Jelte-Boumans/soldeertin-dispenser/Posters/Illustratieve poster V4.pdf

# MANUEEL DRAAD KNIPPEN STOPT HIER STOP

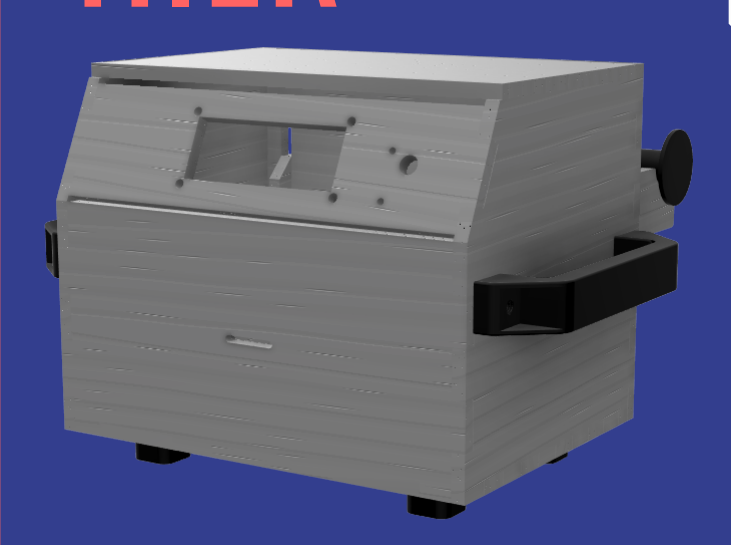
[picture p1: figure]

AUTOMATIC SOLDER DISPENSER COMING SOON TO AP HOGESCHOOL

Made by Jelte Boumans
