Jelte-Boumans/soldeertin-dispenser/Posters/Informatieve poster V1.pdf

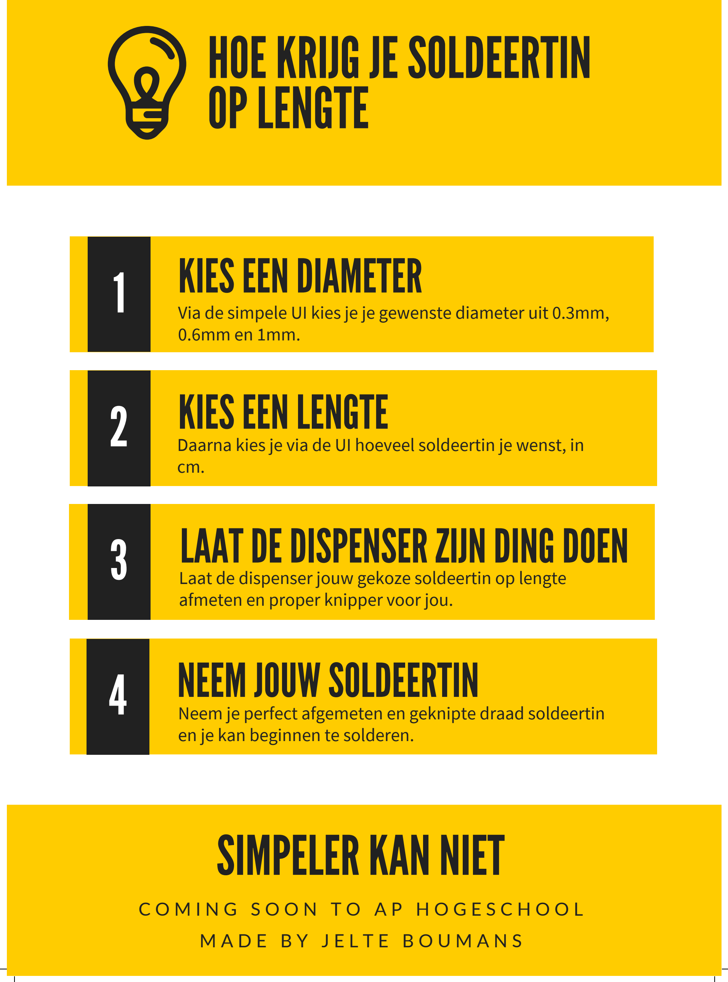
[picture p40: figure]
HOEKRIJGJESOLDEERTIN OPLENGTE; KIESEENDIAMETER; LAATDEDISPENSERZIJNDINGDOEN; afmeten en proper knipper voor jou.; NEEM JOUW SOLDEERTIN; en je kan beginnen te solderen.; SIMPELERKANNIET; KIESEENLENGTE

Via de simpele UI kies je je gewenste diameter uit 0.3mm,

Laat de dispenser jouw gekoze soldeertin op lengte

Neem je perfect afgemeten en geknipte draad soldeertin

C O M I N G S O O N T O A P H O G E S C H O O L

Daarna kies je via de UI hoeveel soldeertin je wenst, in
