Jelte-Boumans/soldeertin-dispenser/Blokdiagram/Hardware diagram.png

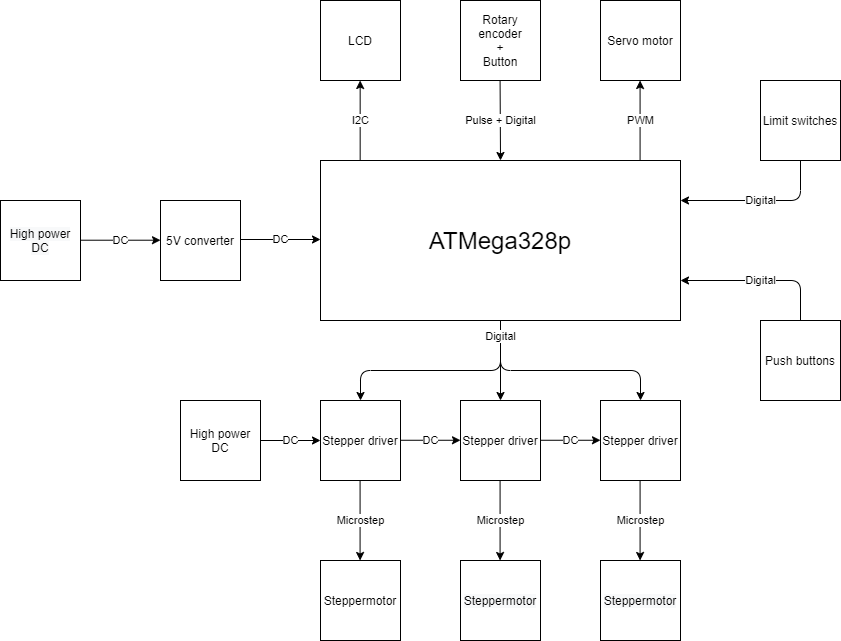
Blokdiagram/Hardware diagram.png
