Jelte-Boumans/soldeertin-dispenser/Schema/Soldeertin_dispenser.brd

## EAGLE design Schema/Soldeertin_dispenser.brd (2023-07-24)

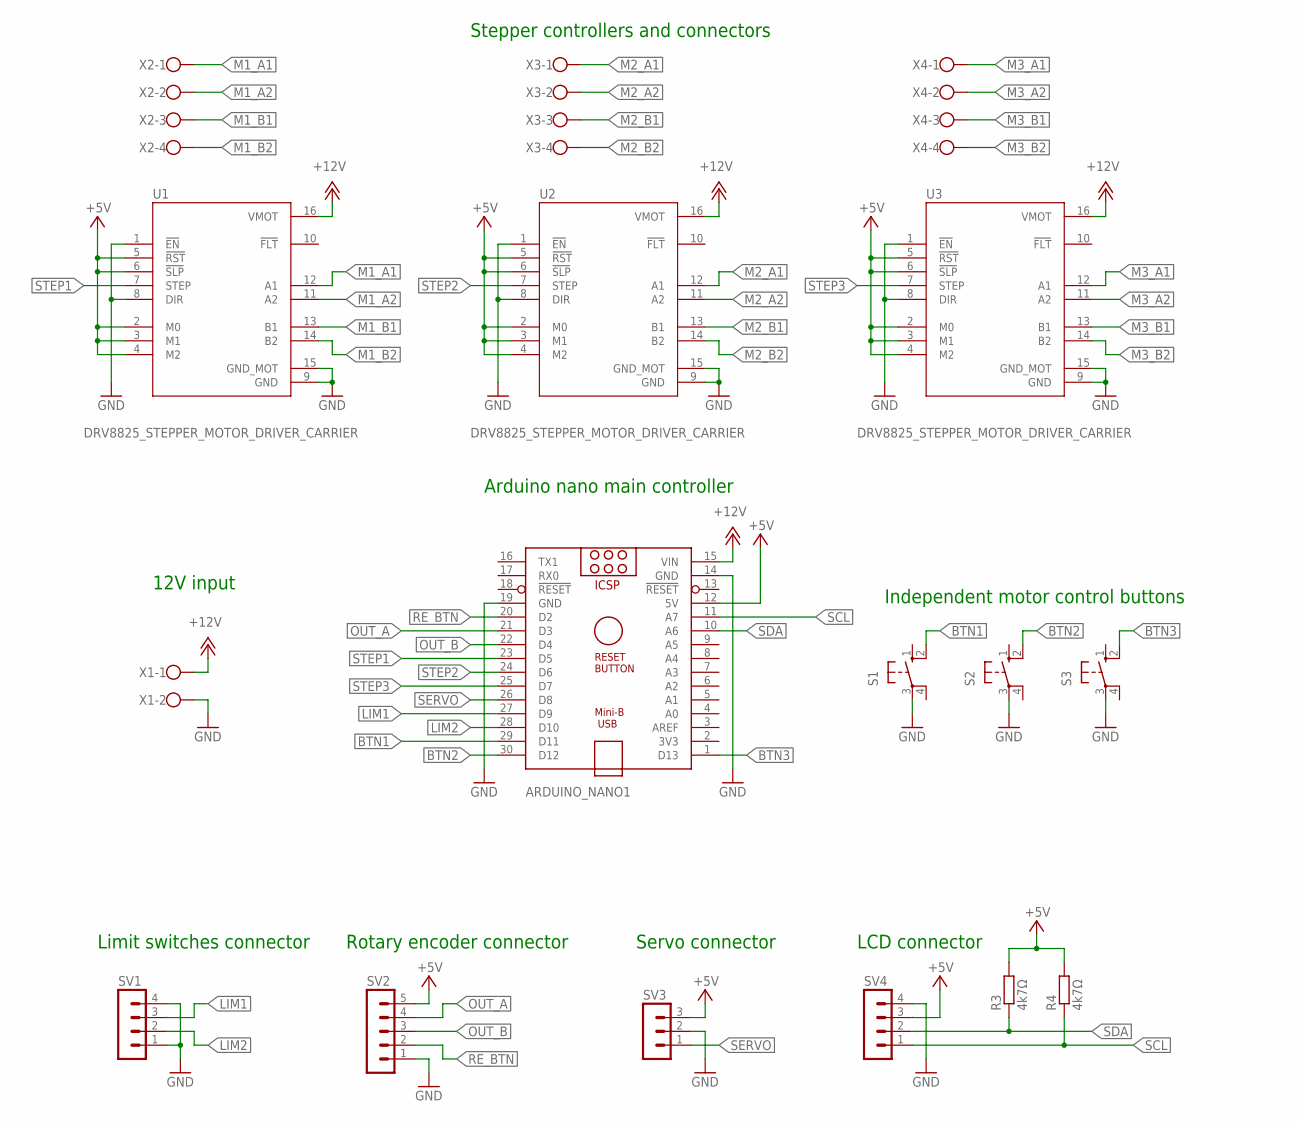
[picture p52: schematic Soldeertin_dispenser.sch]

Parts:
ARDUINO_NANO1: ARDUINO_NANO
R3, R4: 4k7Ω; 0207/10
S1, S2, S3: 10-XX; B3F-10XX
SV1, SV4: MA04-1
SV2: MA05-1
SV3: MA03-1
U1, U2, U3: DRV8825_STEPPER_MOTOR_DRIVER_CARRIER; IC_DRV8825_STEPPER_MOTOR_DRIVER_CARRIER
X1: W237-102
X2, X3, X4: W237-4

Connections:
+5V: ARDUINO_NANO1.12 (5V), R3.2, R4.2, SV2.5, SV3.3, SV4.3, U1.2 (M0), U1.3 (M1), U1.4 (M2), U1.5 (!RST), U1.6 (!SLP), U2.2 (M0), U2.3 (M1), U2.4 (M2), U2.5 (!RST), U2.6 (!SLP), U3.2 (M0), U3.3 (M1), U3.4 (M2), U3.5 (!RST), U3.6 (!SLP)
+12V: ARDUINO_NANO1.15 (VIN), U1.16 (VMOT), U2.16 (VMOT), U3.16 (VMOT), X1.1
BTN1: ARDUINO_NANO1.29 (D11), S1.2 (S1)
BTN2: ARDUINO_NANO1.30 (D12), S2.2 (S1)
BTN3: ARDUINO_NANO1.1 (D13), S3.2 (S1)
GND: ARDUINO_NANO1.14 (GND), ARDUINO_NANO1.19 (GND), S1.3, S2.3, S3.3, SV1.1, SV1.4, SV2.1, SV3.2, SV4.4, U1.1 (!EN), U1.8 (DIR), U1.9 (GND), U1.15 (GND_MOT), U2.1 (!EN), U2.8 (DIR), U2.9 (GND), U2.15 (GND_MOT), U3.1 (!EN), U3.8 (DIR), U3.9 (GND), U3.15 (GND_MOT), X1.2
LIM1: ARDUINO_NANO1.27 (D9), SV1.3
LIM2: ARDUINO_NANO1.28 (D10), SV1.2
M1_A1: U1.12 (A1), X2.1
M1_A2: U1.11 (A2), X2.2
M1_B1: U1.13 (B1), X2.3
M1_B2: U1.14 (B2), X2.4
M2_A1: U2.12 (A1), X3.1
M2_A2: U2.11 (A2), X3.2
M2_B1: U2.13 (B1), X3.3
M2_B2: U2.14 (B2), X3.4
M3_A1: U3.12 (A1), X4.1
M3_A2: U3.11 (A2), X4.2
M3_B1: U3.13 (B1), X4.3
M3_B2: U3.14 (B2), X4.4
OUT_A: ARDUINO_NANO1.21 (D3), SV2.4
OUT_B: ARDUINO_NANO1.22 (D4), SV2.3
RE_BTN: ARDUINO_NANO1.20 (D2), SV2.2
SCL: ARDUINO_NANO1.11 (A7), R4.1, SV4.1
SDA: ARDUINO_NANO1.10 (A6), R3.1, SV4.2
SERVO: ARDUINO_NANO1.26 (D8), SV3.1
STEP1: ARDUINO_NANO1.23 (D5), U1.7 (STEP)
STEP2: ARDUINO_NANO1.24 (D6), U2.7 (STEP)
STEP3: ARDUINO_NANO1.25 (D7), U3.7 (STEP)

Notes on the sheet:
LCD connector
Limit switches connector
Rotary encoder connector
Servo connector
12V input
Arduino nano main controller
Independent motor control buttons
Stepper controllers and connectors

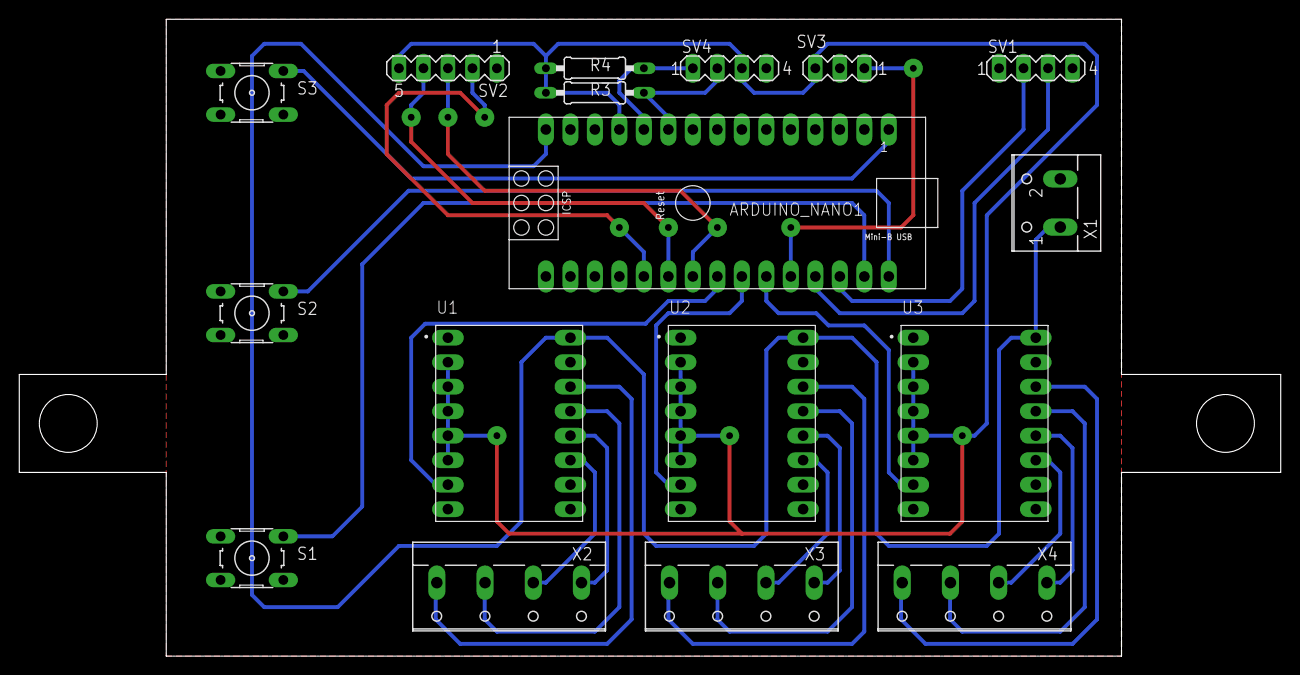
[picture p53: board Soldeertin_dispenser.brd from above]

Board: 2 copper layers, 130.8 x 66.0 mm, 17 parts (0 on the bottom side), 29 nets.
